Mettocks/OcuFeel_Public/(list of files, drawings)

Other design files:
OcuFeel_Waistband_PCB_Files/MCP.SchDoc
OcuFeel_Waistband_PCB_Files/PowerBooster.SchDoc
OcuFeel_Waistband_PCB_Files/Waistband.PcbDoc
OcuFeel_Waistband_PCB_Files/Waistband_mcu.SchDoc
OcuFeel_Waistband_PCB_Files/Waistband_motorDrivers.SchDoc
OcuFeel_Waistband_PCB_Files/Waistband_shiftRegisters.SchDoc
